BenAuc/Wrist/CAD Mechanical Design/Images/Prototype v1_photo2.jpg

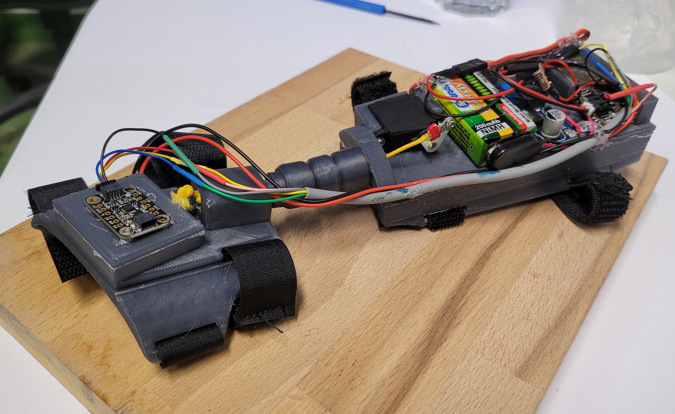
CAD Mechanical Design/Images/Prototype v1_photo2.jpg
