BenAuc/Wrist/CAD Mechanical Design/Images/Prototype v1_photo1.jpg

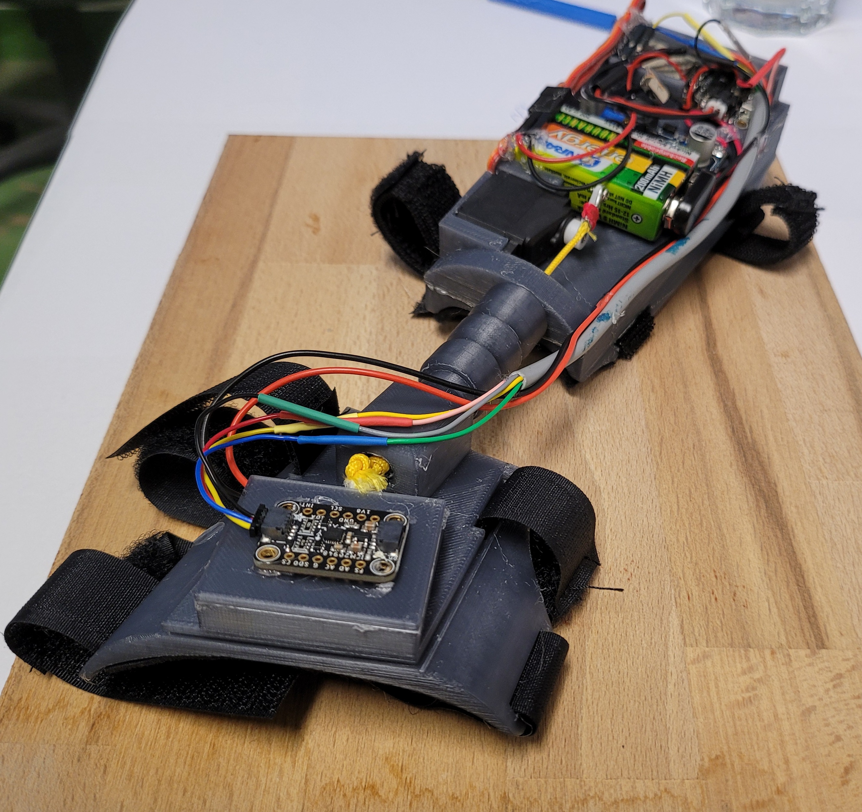
CAD Mechanical Design/Images/Prototype v1_photo1.jpg
