BenAuc/Wrist/README.md

# Wrist
CAD design (in Autodesk) of an exoskeleton for the wrist integrating IMU sensors and servo moter and aimed at dampening tremors characteristic of e.g. Parkinson disease.
