BenAuc/Wrist/CAD Mechanical Design/README2.md

# Neurorehabilitation_project_TuMove

Code for the project damping tremor exoskeleton - TuMove - Lecture Neurorehabilitation SS. 2022

## Description
This repository contains code which can be uploaded to the esp-32 board of the tremor damping exoskeleton (in [IMU-INTERFACE](https://gitlab.lrz.de/00000000014B0AE3/neurorehabilitation_project_tumove/-/tree/main/IMU-INTERFACE)), CAD-models for different components of the exoskeleton which were 3D-printed (in [CAD-Models](https://gitlab.lrz.de/00000000014B0AE3/neurorehabilitation_project_tumove/-/tree/main/CAD-Models)), circuit diagram (in [Circuit](https://gitlab.lrz.de/00000000014B0AE3/neurorehabilitation_project_tumove/-/tree/main/Circuit)), and the experimental evaluation data (in [Data](https://gitlab.lrz.de/00000000014B0AE3/neurorehabilitation_project_tumove/-/tree/main/Data)).

## Installation
To run the code from this project on esp32 feather board, download or clone [IMU-INTERFACE](https://gitlab.lrz.de/00000000014B0AE3/neurorehabilitation_project_tumove/-/tree/main/IMU-INTERFACE) and open it with [PlatformIO](https://docs.platformio.org/en/latest/what-is-platformio.html). Build the project and upload it to the esp 32 feather board. More information about these steps can be found on
[PlatformIO - Getting Started](https://docs.platformio.org/en/latest/tutorials/index.html)

## Authors
Thien Le, Benoit Auclair, Klara Tomasković, Jose Garcia-Higuera
