BenAuc/Wrist/Images of prototype/CAD-hand-original.jpg

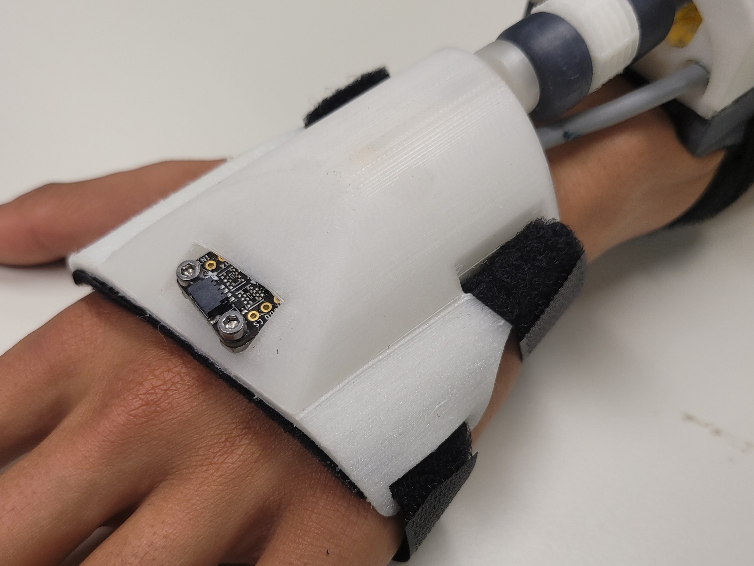
Images of prototype/CAD-hand-original.jpg
