BenAuc/Wrist/Images of prototype/CAD-mechanism2.jpg

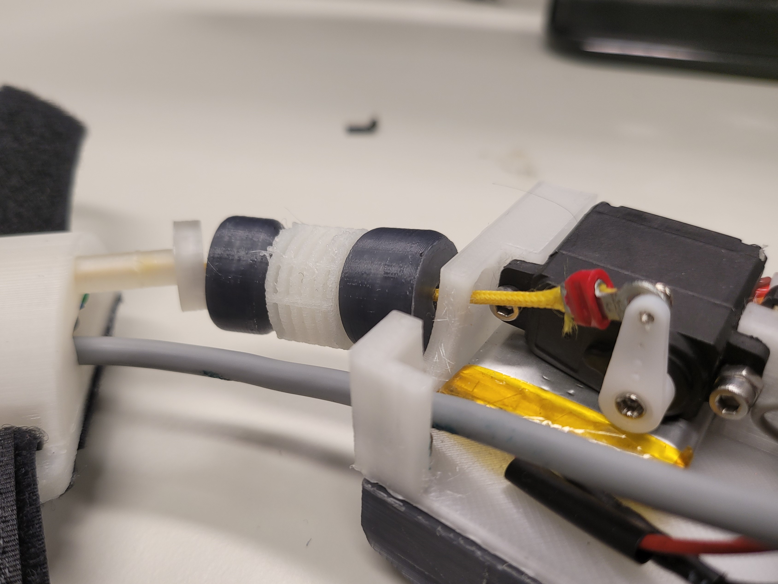
Images of prototype/CAD-mechanism2.jpg
