BenAuc/Wrist/Images of prototype/CAD-whole-original.jpg

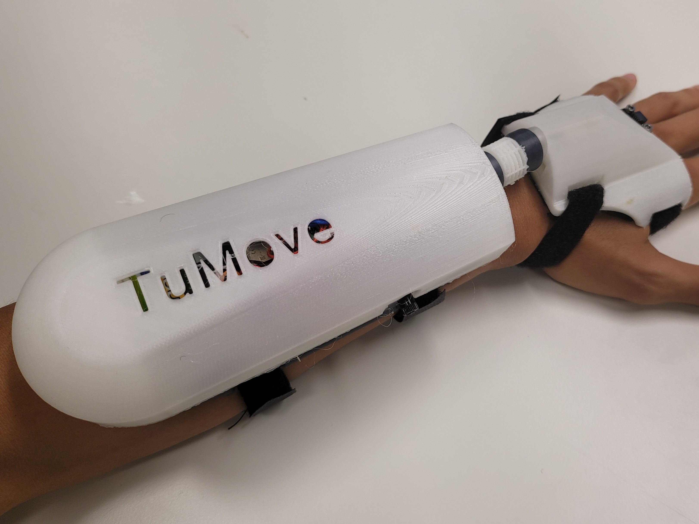
Images of prototype/CAD-whole-original.jpg
