BenAuc/Wrist/Back Hand Assembly v2 v6.stl

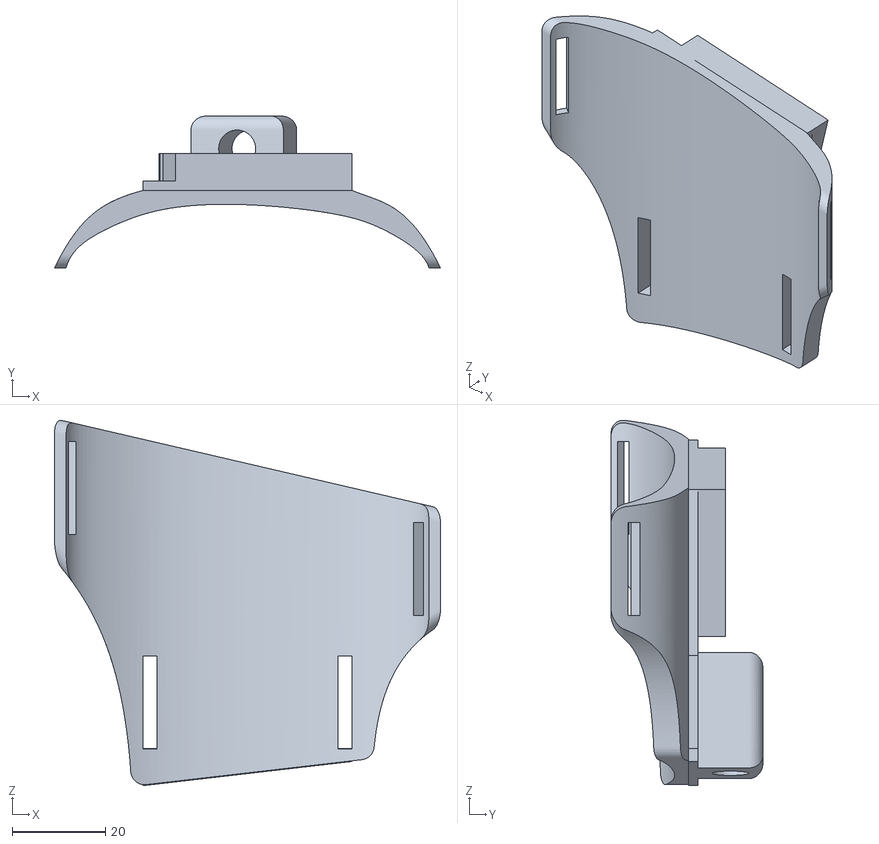
[picture p16: CAD file, 2022-07-06]
Back Hand Assembly v2 v6.stl
83.0 x 32.7 x 78.6
