BenAuc/Wrist/Back Hand Top Assembly v2 v7.stl

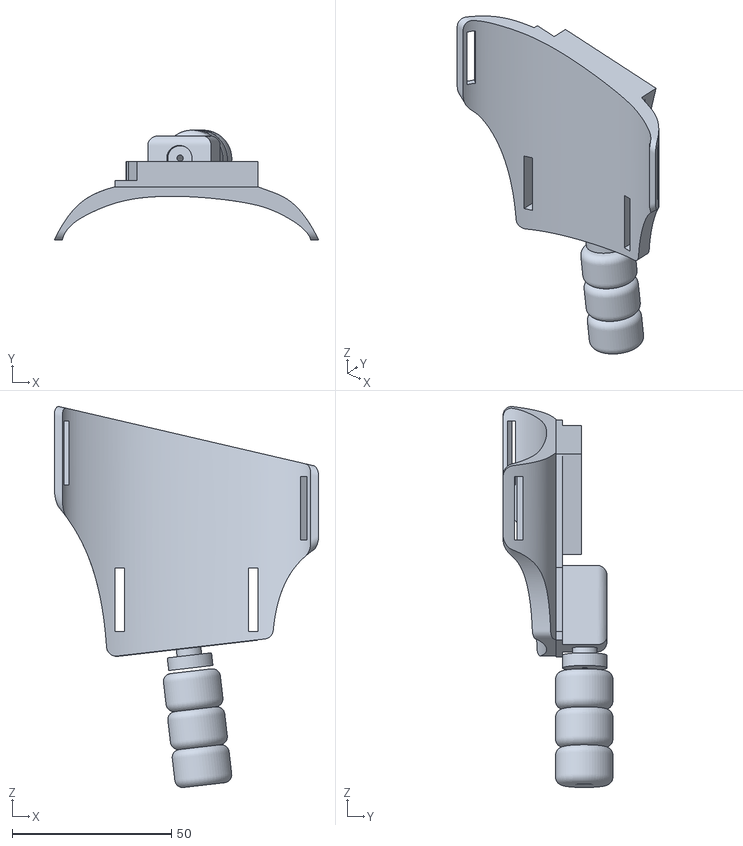
[picture p17: CAD file, 2022-07-06]
Back Hand Top Assembly v2 v7.stl
83.0 x 34.5 x 119.6
