BenAuc/Wrist/Wrist Exo v4 v7.stl

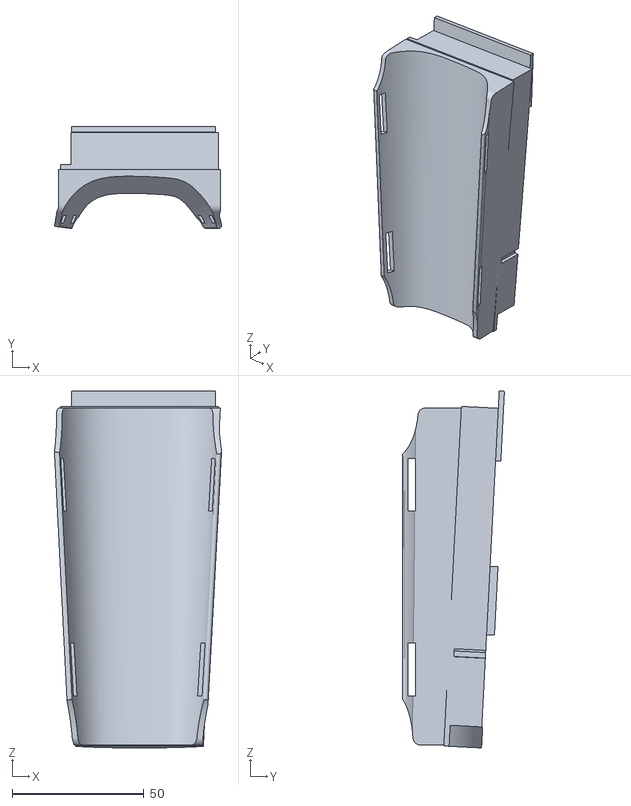
[picture p18: CAD file, 2022-07-06]
Wrist Exo v4 v7.stl
63.4 x 38.6 x 135.3
