BenAuc/Wrist/Back Hand Exo v4 v4.stl

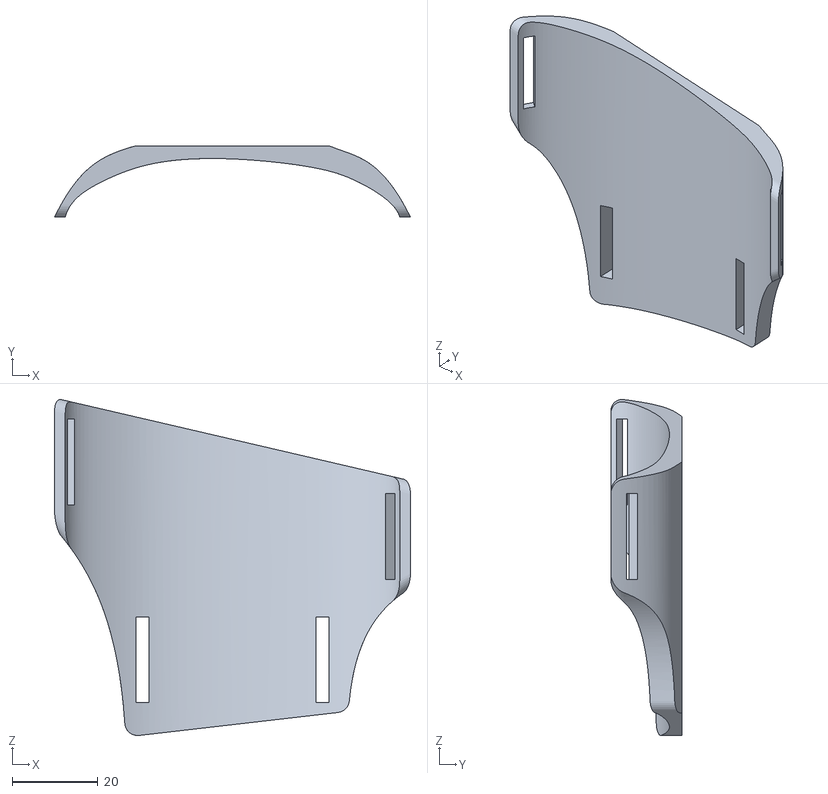
[picture p19: CAD file, 2022-07-06]
Back Hand Exo v4 v4.stl
83.0 x 16.7 x 78.3
