BenAuc/Wrist/(list of files, cad)

Other CAD files:
Forearm Entire Assembly_v2 v9.stl
CAD Mechanical Design/Other & archive/Forearm Entire Assembly_v2 v9.stl
Back Hand Assembly v2 v6.f3z
Back Hand Exo v4 v4.f3d
Back Hand Top Assembly v2 v7.f3z
CAD Mechanical Design/Model of Components (Batteries, servo, etc)/Battery 3.3V v2.f3d
CAD Mechanical Design/Model of Components (Batteries, servo, etc)/Battery 9V v2.f3d
CAD Mechanical Design/Model of Components (Batteries, servo, etc)/Feather board v1.f3d
CAD Mechanical Design/Model of Components (Batteries, servo, etc)/IMU sensor v1.f3d
CAD Mechanical Design/Model of Components (Batteries, servo, etc)/Potentiometer v3.f3d
CAD Mechanical Design/Model of Components (Batteries, servo, etc)/Small servo v1.f3d
CAD Mechanical Design/Other & archive/Back Hand Assembly v2 v6.f3z
CAD Mechanical Design/Other & archive/Back Hand Exo v4 v4.f3d
CAD Mechanical Design/Other & archive/Back Hand Top Assembly v2 v7.f3z
CAD Mechanical Design/Other & archive/Forearm Entire Assembly_v2 v9.f3z
CAD Mechanical Design/Other & archive/Wrist Exo v4 v7.f3z
CAD Mechanical Design/Prototype Pucks-springs-squeezer/Puck_10 mm h v1.f3d
CAD Mechanical Design/Prototype Pucks-springs-squeezer/Pucks squeezer v2 v1.f3d
CAD Mechanical Design/Prototype Pucks-springs-squeezer/Spring_11 mm h_v4 v2.f3d
CAD Mechanical Design/Prototype Pucks-springs-squeezer/Spring_11 mm h_v5 v2.f3d
CAD Mechanical Design/Prototype Pucks-springs-squeezer/Spring_11 mm h_v6 v1.f3d
CAD Mechanical Design/Prototype v3/Back Hand Exo Bottom v4 v1.f3d
CAD Mechanical Design/Prototype v3/Back Hand Exo Bottom v4-flex material version v2.f3d
CAD Mechanical Design/Prototype v3/Back Hand Exo Top v2 v5.f3d
CAD Mechanical Design/Prototype v3/Wrist Exo Bottom v5 v1.f3d
CAD Mechanical Design/Prototype v3/Wrist Exo Top Assembly v1.f3z
CAD Mechanical Design/Prototype v3/Wrist Exo Top Lid v2 v7.f3d
Forearm Entire Assembly_v2 v9.f3z
Wrist Exo v4 v7.f3z
