BenAuc/Wrist/CAD Mechanical Design/Images/Whole Forearm Assembly.PNG

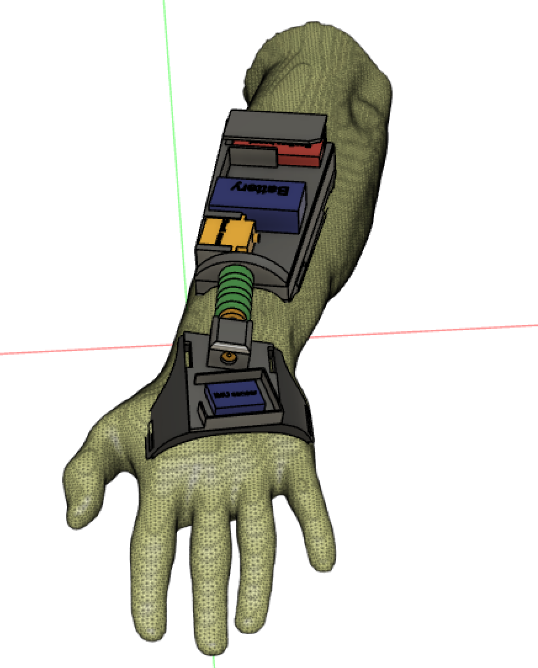
CAD Mechanical Design/Images/Whole Forearm Assembly.PNG
