BenAuc/Wrist/(list of files, drawings)

Other design files:
System Electronics & Circuit/diagram.fzz
