BenAuc/Wrist/(commit log)

2022-07-06 Initial file upload
    [Back Hand Assembly v2 v6.f3z, Back Hand Assembly v2 v6.stl, Back Hand Exo v4 v4.f3d, Back Hand Exo v4 v4.stl, Back Hand Top Assembly v2 v7.f3z, Back Hand Top Assembly v2 v7.stl, Forearm Entire Assembly_v2 v9.f3z, Forearm Entire Assembly_v2 v9.stl]
2022-07-08 added photos of assembled prototype v1
2022-07-28 added images of prototype and figures
2022-08-07 Added code & system electric diagram
    [diagram.fzz]
2022-08-07 Added final version of CADs
    [Back Hand Assembly v2 v6.f3z, Back Hand Assembly v2 v6.stl, Back Hand Exo Bottom v4 v1.f3d, Back Hand Exo Bottom v4-flex material version v2.f3d, Back Hand Exo Top v2 v5.f3d, Back Hand Exo v4 v4.f3d, Back Hand Exo v4 v4.stl, Back Hand Top Assembly v2 v7.f3z]
